reilleya/oven/readme.md

# Oven Controller
This repository contains the KiCAD PCB design and rust firmware for an oven controller intended for use in custom composite curing ovens.
