reilleya/oven/hardware/controller/components/TPS1H200AQDGNRQ1/TPS1H200AQDGNRQ1.step

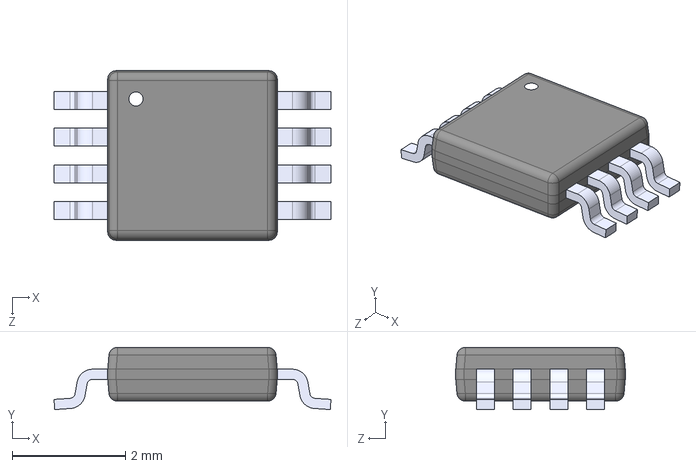
[picture p1: CAD file, 2025-11-11]
hardware/controller/components/TPS1H200AQDGNRQ1/TPS1H200AQDGNRQ1.step
4.90 x 1.10 x 3.00 mm
