reilleya/oven/hardware/controller/components/ul_MPM3606AGQV-P/MPM3606.STEP

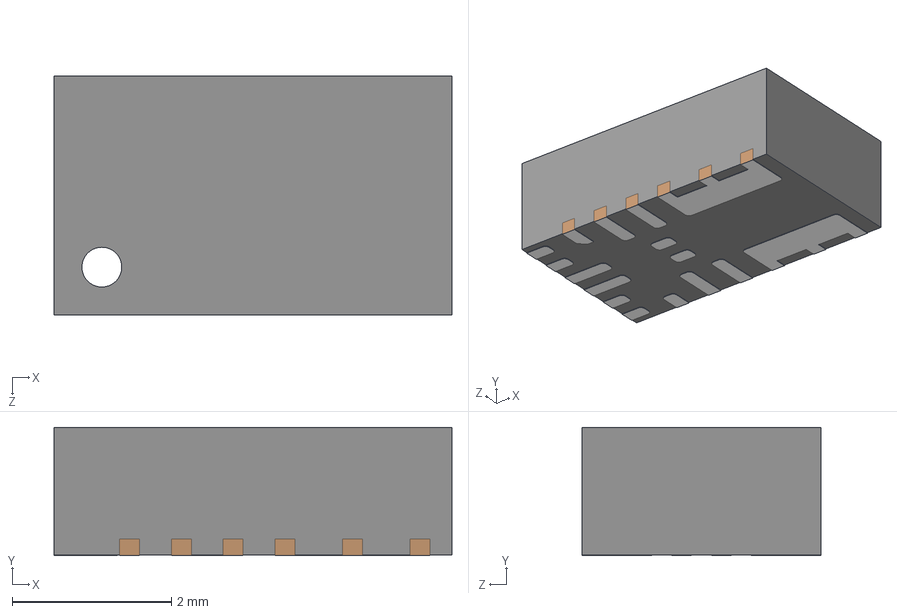
[picture p2: CAD file, 2025-11-11]
hardware/controller/components/ul_MPM3606AGQV-P/MPM3606.STEP
5.00 x 1.61 x 3.00 mm
