reilleya/oven/hardware/controller/components/LM73100RPWR/LM73100RPWR.step

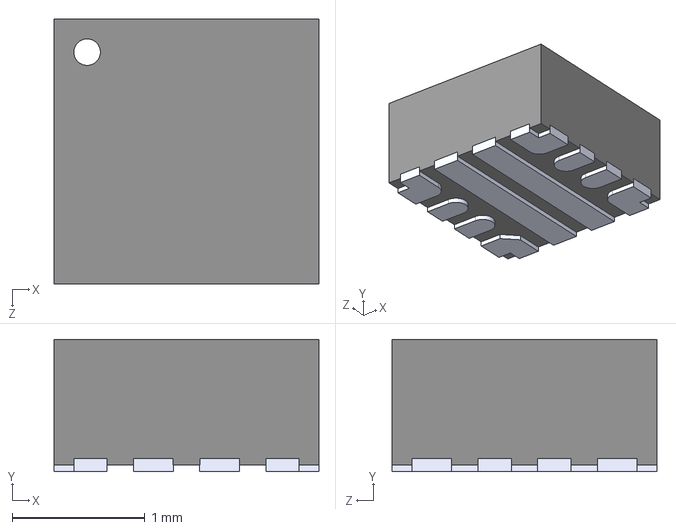
[picture p3: CAD file, 2025-11-11]
hardware/controller/components/LM73100RPWR/LM73100RPWR.step
2.00 x 1.00 x 2.00 mm
