reilleya/oven/hardware/controller/controller.kicad_pcb

## KiCad design hardware/controller/controller.kicad_pcb (2026-01-15)

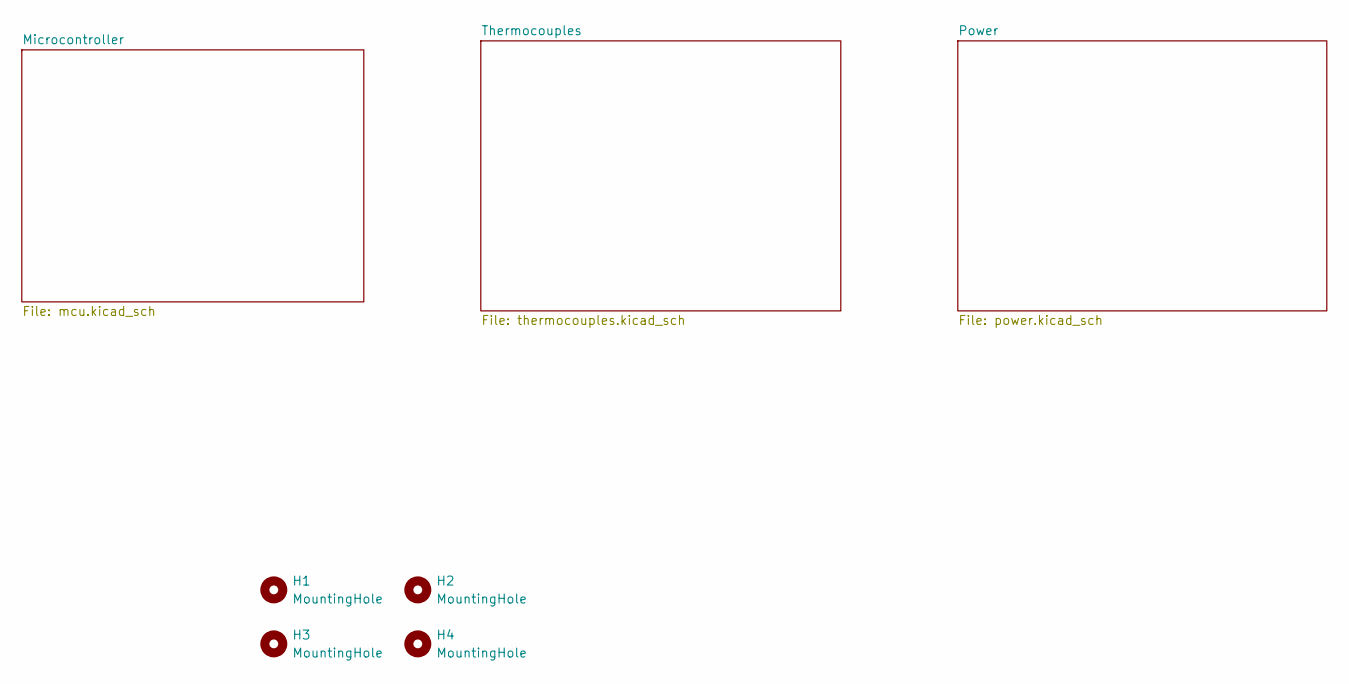
[picture p4: schematic controller.kicad_sch]

Parts:
H1, H2, H3, H4: MountingHole; MountingHole_2.2mm_M2_ISO14580_Pad

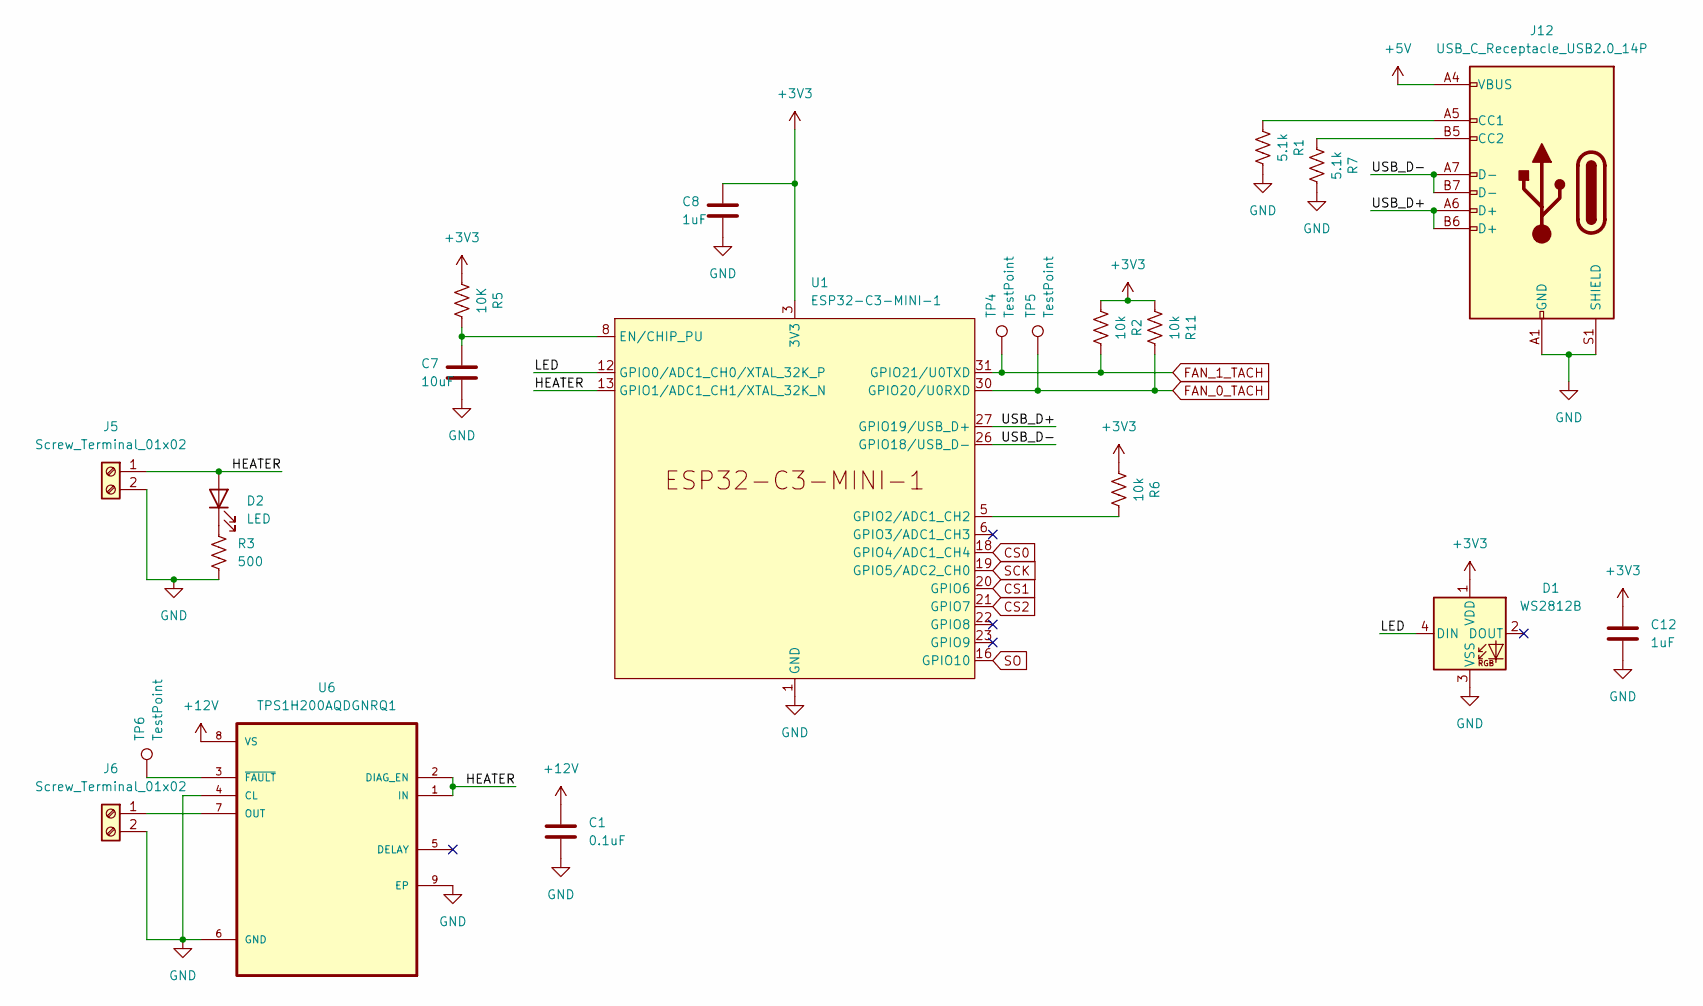
[picture p5: schematic mcu.kicad_sch]

Parts:
C1: 0.1uF; C_0805_2012Metric; LCSC C49678
C7: 10uF; C_0805_2012Metric; LCSC` C15850
C8, C12: 1uF; C_0805_2012Metric; LCSC C28323
D1: WS2812B; LED_WS2812B_PLCC4_5.0x5.0mm_P3.2mm; LCSC C2874885
D2: LED; LED_0805_2012Metric; LCSC C84256
J5, J6: Screw_Terminal_01x02; TerminalBlock_4Ucon_1x02_P3.50mm_Horizontal
J12: USB_C_Receptacle_USB2.0_14P; USB_C_Receptacle_GCT_USB4105-xx-A_16P_TopMnt_Horizontal; LCSC C2765186
R1, R7: 5.1k; R_0805_2012Metric; LCSC C27834
R2, R6, R11: 10k; R_0805_2012Metric; LCSC C84376
R3: 500; R_0805_2012Metric; LCSC C2828857
R5: 10K; R_0805_2012Metric; LCSC C84376
TP4, TP5, TP6: TestPoint; TestPoint_THTPad_2.0x2.0mm_Drill1.0mm
U1: ESP32-C3-MINI-1; LCSC C2838502
U6: TPS1H200AQDGNRQ1; SOP65P490X110-9N; LCSC C2653785

Connections:
+3V3: C8.1, C12.1, D1.1 (VDD), R2.2, R5.2, R6.2, R11.2, U1.3 (3V3); also elsewhere on the board
+5V: J12.A4 (VBUS), J12.A9 (VBUS), J12.B4 (VBUS), J12.B9 (VBUS); also elsewhere on the board
+12V: C1.1, U6.8 (VS); also elsewhere on the board
/Microcontroller/HEATER: D2.2 (A), J5.1, U1.13 (GPIO1/ADC1_CH1/XTAL_32K_N), U6.1 (IN), U6.2 (DIAG_EN)
/Microcontroller/LED: D1.4 (DIN), U1.12 (GPIO0/ADC1_CH0/XTAL_32K_P)
/Microcontroller/USB_D+: J12.A6 (D+), J12.B6 (D+), U1.27 (GPIO19/USB_D+)
/Microcontroller/USB_D-: J12.A7 (D-), J12.B7 (D-), U1.26 (GPIO18/USB_D-)
CS0: U1.18 (GPIO4/ADC1_CH4); also elsewhere on the board
CS1: U1.20 (GPIO6); also elsewhere on the board
CS2: U1.21 (GPIO7); also elsewhere on the board
FAN_0_TACH: R11.1, TP5.1, U1.30 (GPIO20/U0RXD); also elsewhere on the board
FAN_1_TACH: R2.1, TP4.1, U1.31 (GPIO21/U0TXD); also elsewhere on the board
GND: C1.2, C7.2, C8.2, C12.2, D1.3 (VSS), J5.2, J6.2, J12.A1 (GND), J12.A12 (GND), J12.B1 (GND), J12.B12 (GND), J12.S1 (SHIELD), R1.1, R3.2, R7.1, U1.1 (GND), U1.2 (GND), U1.11 (GND), U1.14 (GND), U1.36 (GND), U1.37 (GND), U1.38 (GND), U1.39 (GND), U1.40 (GND), U1.41 (GND), U1.42 (GND), U1.43 (GND), U1.44 (GND), U1.45 (GND), U1.46 (GND), U1.47 (GND), U1.48 (GND), U1.49 (GND), U1.50 (GND), U1.51 (GND), U1.52 (GND), U1.53 (GND), U6.4 (CL), U6.6 (GND), U6.9 (EP); also elsewhere on the board
unnamed: D2.1 (K), R3.1
unnamed: J6.1, U6.7 (OUT)
unnamed: J12.A5 (CC1), R1.2
unnamed: J12.B5 (CC2), R7.2
unnamed: C7.1, R5.1, U1.8 (EN/CHIP_PU)
unnamed: R6.1, U1.5 (GPIO2/ADC1_CH2)
unnamed: TP6.1, U6.3 (~FAULT)
SCK: U1.19 (GPIO5/ADC2_CH0); also elsewhere on the board
SO: U1.16 (GPIO10); also elsewhere on the board

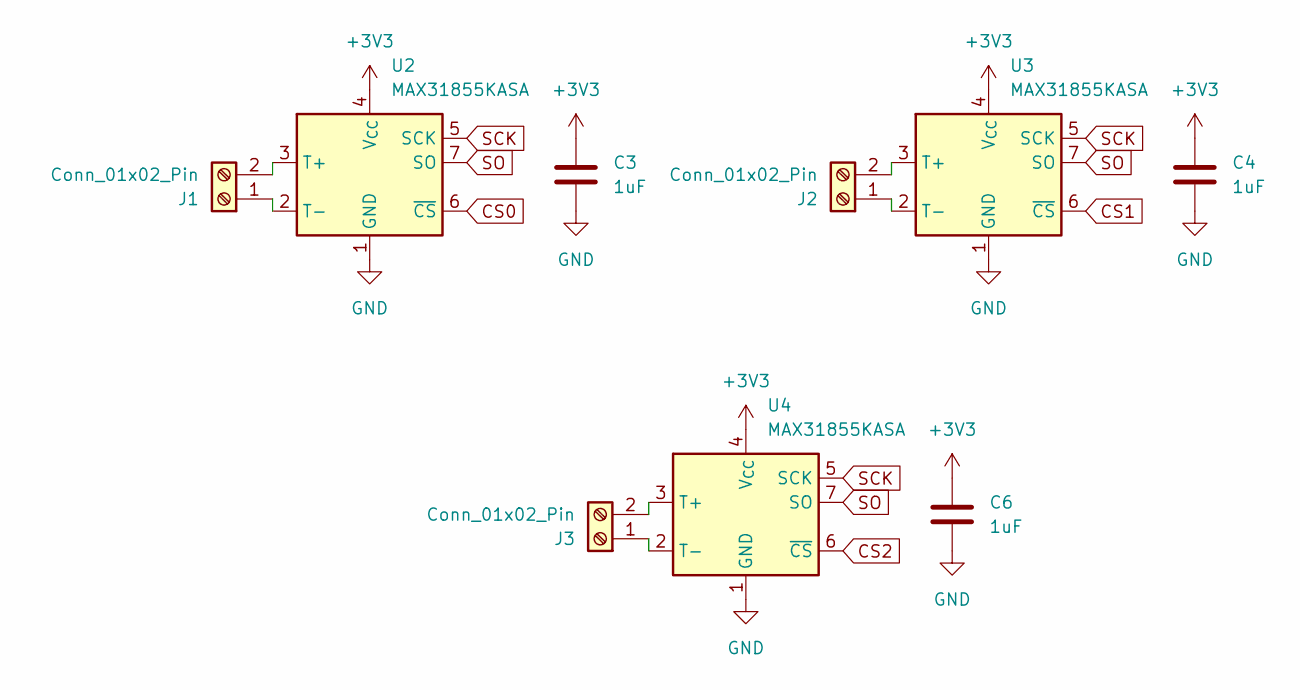
[picture p6: schematic thermocouples.kicad_sch]

Parts:
C3, C4, C6: 1uF; C_0805_2012Metric; LCSC C28323
J1, J2, J3: Conn_01x02_Pin; TerminalBlock_4Ucon_1x02_P3.50mm_Horizontal
U2, U3, U4: MAX31855KASA; SOIC-8_3.9x4.9mm_P1.27mm; LCSC C52028

Connections:
+3V3: C3.1, C4.1, C6.1, U2.4 (V_{CC}), U3.4 (V_{CC}), U4.4 (V_{CC}); also elsewhere on the board
CS0: U2.6 (~CS); also elsewhere on the board
CS1: U3.6 (~CS); also elsewhere on the board
CS2: U4.6 (~CS); also elsewhere on the board
GND: C3.2, C4.2, C6.2, U2.1 (GND), U3.1 (GND), U4.1 (GND); also elsewhere on the board
unnamed: J1.1, U2.2 (T-)
unnamed: J1.2, U2.3 (T+)
unnamed: J2.1, U3.2 (T-)
unnamed: J2.2, U3.3 (T+)
unnamed: J3.1, U4.2 (T-)
unnamed: J3.2, U4.3 (T+)
SCK: U2.5 (SCK), U3.5 (SCK), U4.5 (SCK); also elsewhere on the board
SO: U2.7 (SO), U3.7 (SO), U4.7 (SO); also elsewhere on the board

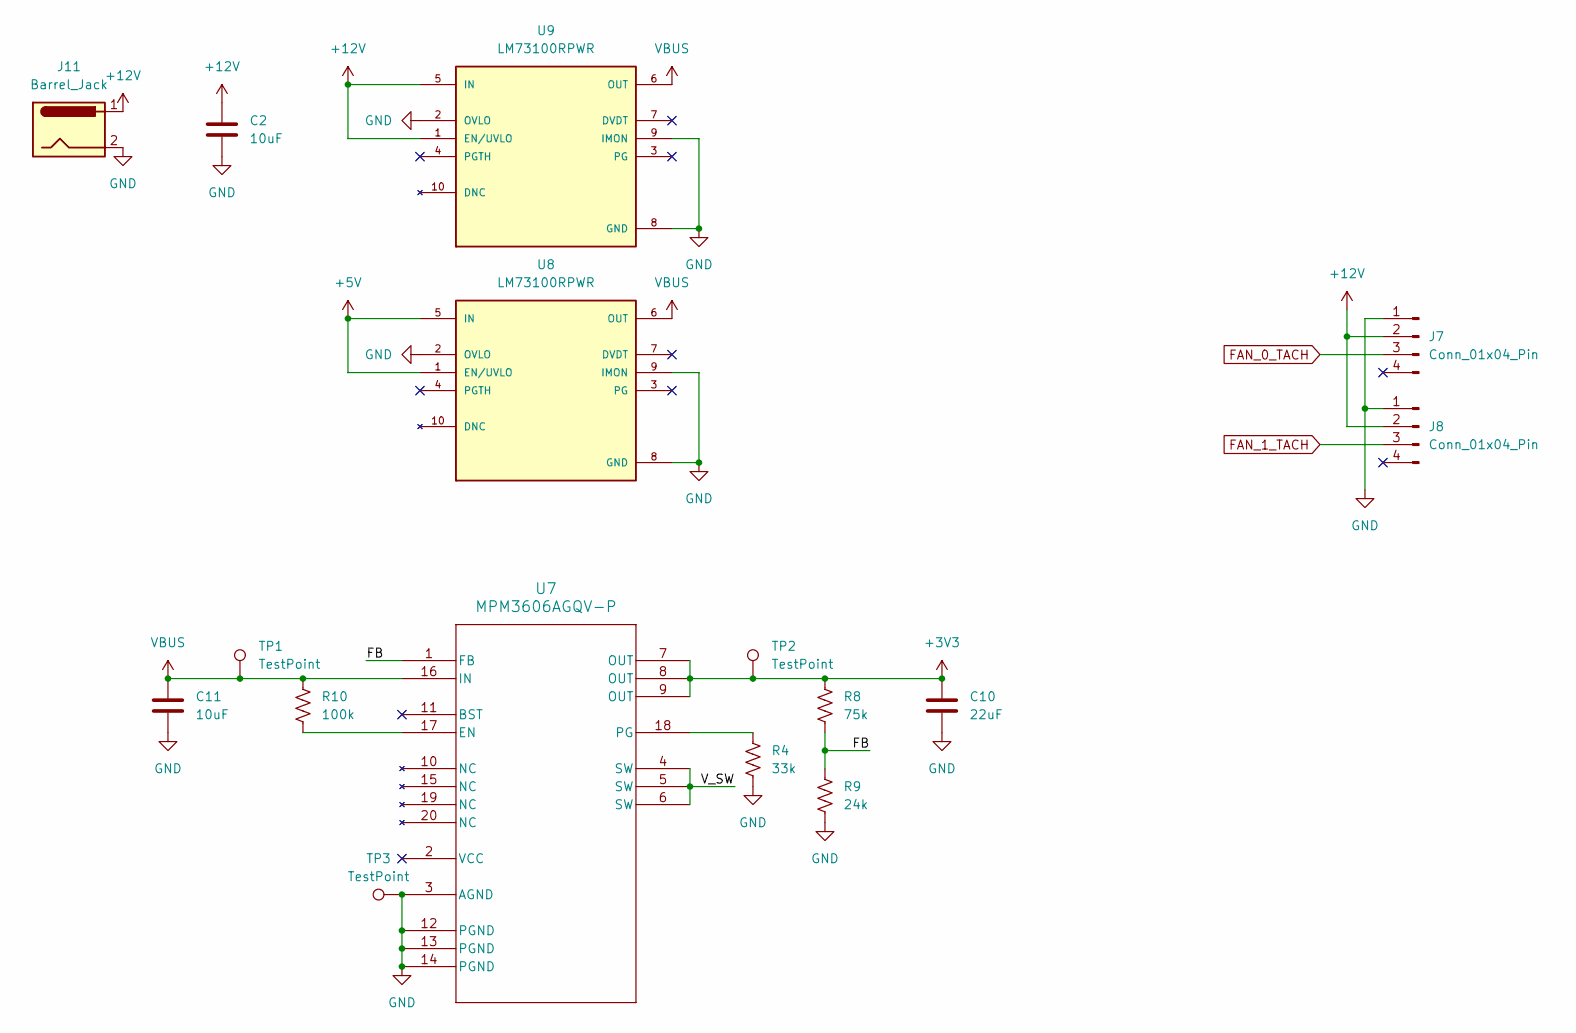
[picture p7: schematic power.kicad_sch]

Parts:
C2, C11: 10uF; C_0805_2012Metric; LCSC C15850
C10: 22uF; C_0805_2012Metric; LCSC C602037
J7, J8: Conn_01x04_Pin; FanPinHeader_1x04_P2.54mm_Vertical
J11: Barrel_Jack; BarrelJack_CUI_PJ-063AH_Horizontal
R4: 33k; R_0805_2012Metric; LCSC C17633
R8: 75k; R_0805_2012Metric; LCSC C17819
R9: 24k; R_0805_2012Metric; LCSC C17575
R10: 100k; R_0805_2012Metric; LCSC C96346
TP1, TP2, TP3: TestPoint; TestPoint_THTPad_2.0x2.0mm_Drill1.0mm
U7: MPM3606AGQV-P; QFN3p0x5p0x1p6_MPM3606A_MNP; LCSC C7305220
U8, U9: LM73100RPWR; IC_LM73100RPWR; PARTREV 08/2019; LCSC C3210761

Connections:
+3V3: C10.1, R8.1, TP2.1, U7.7 (OUT), U7.8 (OUT), U7.9 (OUT); also elsewhere on the board
+5V: U8.1 (EN/UVLO), U8.5 (IN); also elsewhere on the board
+12V: C2.1, J7.2, J8.2, J11.1, U9.1 (EN/UVLO), U9.5 (IN); also elsewhere on the board
/Power/FB: R8.2, R9.1, U7.1 (FB)
/Power/V_SW: U7.4 (SW), U7.5 (SW), U7.6 (SW)
FAN_0_TACH: J7.3; also elsewhere on the board
FAN_1_TACH: J8.3; also elsewhere on the board
GND: C2.2, C10.2, C11.2, J7.1, J8.1, J11.2, R4.2, R9.2, TP3.1, U7.3 (AGND), U7.12 (PGND), U7.13 (PGND), U7.14 (PGND), U8.2 (OVLO), U8.8 (GND), U8.9 (IMON), U9.2 (OVLO), U9.8 (GND), U9.9 (IMON); also elsewhere on the board
unnamed: R10.2, U7.17 (EN)
unnamed: R4.1, U7.18 (PG)
VBUS: C11.1, R10.1, TP1.1, U7.16 (IN), U8.6 (OUT), U9.6 (OUT)

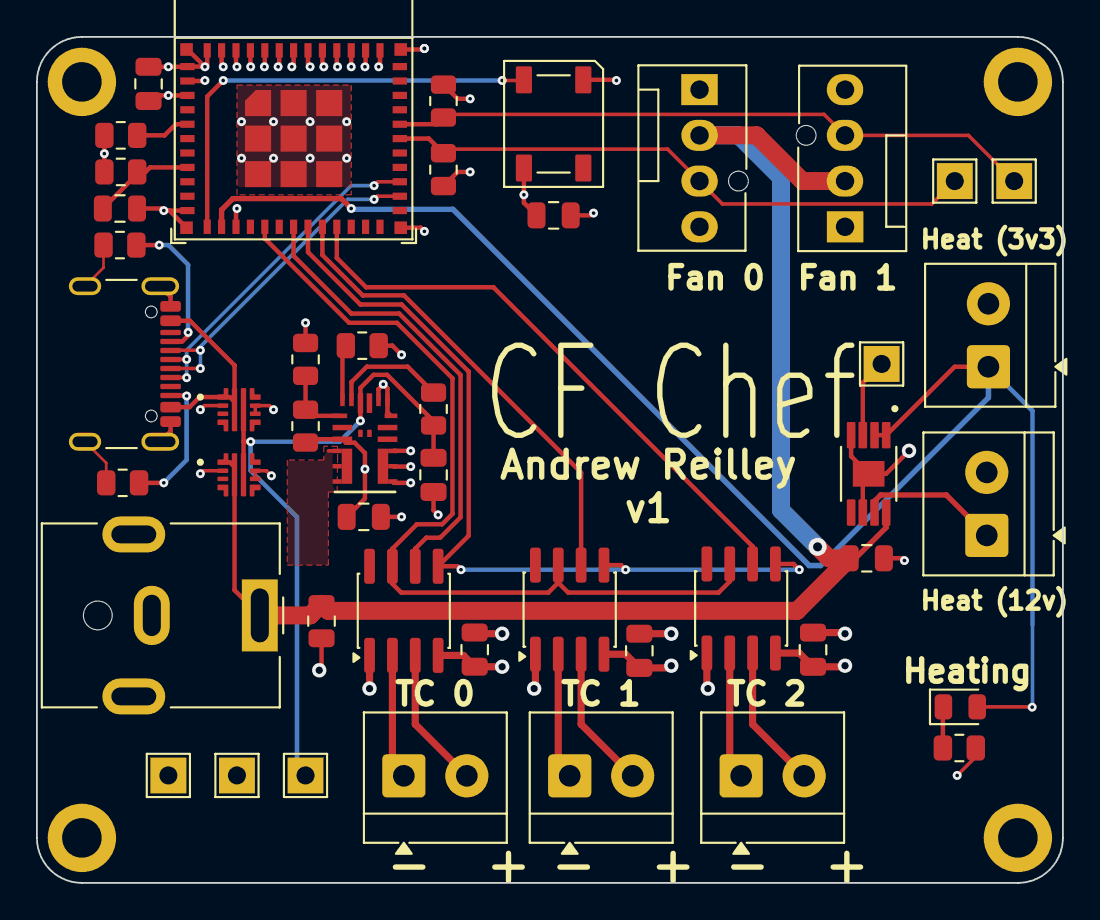
[picture p8: board controller.kicad_pcb from above]

Board: 4 copper layers, 57.0 x 47.0 mm, 50 parts (0 on the bottom side), 33 nets.
