reilleya/oven/(commit log)

2025-11-10 Initial commit, empty firmware and hardware projects
    [controller.kicad_pcb, controller.kicad_sch]
2025-11-10 First sketch of thermocouple/microcontroller hardware design
    [controller.kicad_pcb, controller.kicad_sch, mcu.kicad_sch, power.kicad_sch, thermocouples.kicad_sch]
2025-11-10 Fixed up MCU strapping pins
    [controller.kicad_pcb, mcu.kicad_sch, power.kicad_sch, thermocouples.kicad_sch]
2025-11-11 Filled out power section of schematic
    [LM73100RPWR.step, MPM3606.STEP, TPS1H200AQDGNRQ1.step, controller.kicad_pcb, mcu.kicad_sch, power.kicad_sch, thermocouples.kicad_sch]
2025-11-15 Fix USB symbol, adjust decoupling caps
    [controller.kicad_pcb, mcu.kicad_sch, power.kicad_sch, thermocouples.kicad_sch]
2025-11-15 Drop to 3x thermocouples, 2x fans
    [controller.kicad_pcb, mcu.kicad_sch, power.kicad_sch, thermocouples.kicad_sch]
2025-11-15 Add more decoupling caps
    [controller.kicad_pcb, power.kicad_sch]
2025-12-07 First stab at board routing
    [controller.kicad_pcb, mcu.kicad_sch, power.kicad_sch]
2025-12-09 Layout tweaks
    [controller.kicad_pcb, mcu.kicad_sch]
2025-12-14 Rounded corners, fixed up labels
    [controller.kicad_pcb, mcu.kicad_sch]
2025-12-14 Reroute USB connector
    [controller.kicad_pcb]
2025-12-14 Fix some DRC errors
    [controller.kicad_pcb]
2025-12-15 Zain PCB review
    [controller.kicad_pcb, controller.kicad_sch]
2025-12-16 Route missed trace, add some vias
    [controller.kicad_pcb]
2025-12-20 Add LCSC numbers
    [mcu.kicad_sch, power.kicad_sch, thermocouples.kicad_sch]
2025-12-20 Update some LCSC numbers
    [mcu.kicad_sch, power.kicad_sch]
2025-12-28 Update LED LCSC
    [controller.kicad_pcb, mcu.kicad_sch]
2025-12-31 Add serial number box
    [controller.kicad_pcb, mcu.kicad_sch]
2026-01-03 Update component position offsets for JLC
    [controller.kicad_pcb, mcu.kicad_sch, power.kicad_sch]
2026-01-03 Update vias to larger size for manufacturing
    [controller.kicad_pcb]
2026-01-15 Fix resistor on regulator, space out fan headers more
    [controller.kicad_pcb, power.kicad_sch]
